iotBrainStorm/SOLAR_TRACKING_RS485/photos/Circuit_Diagram.pdf

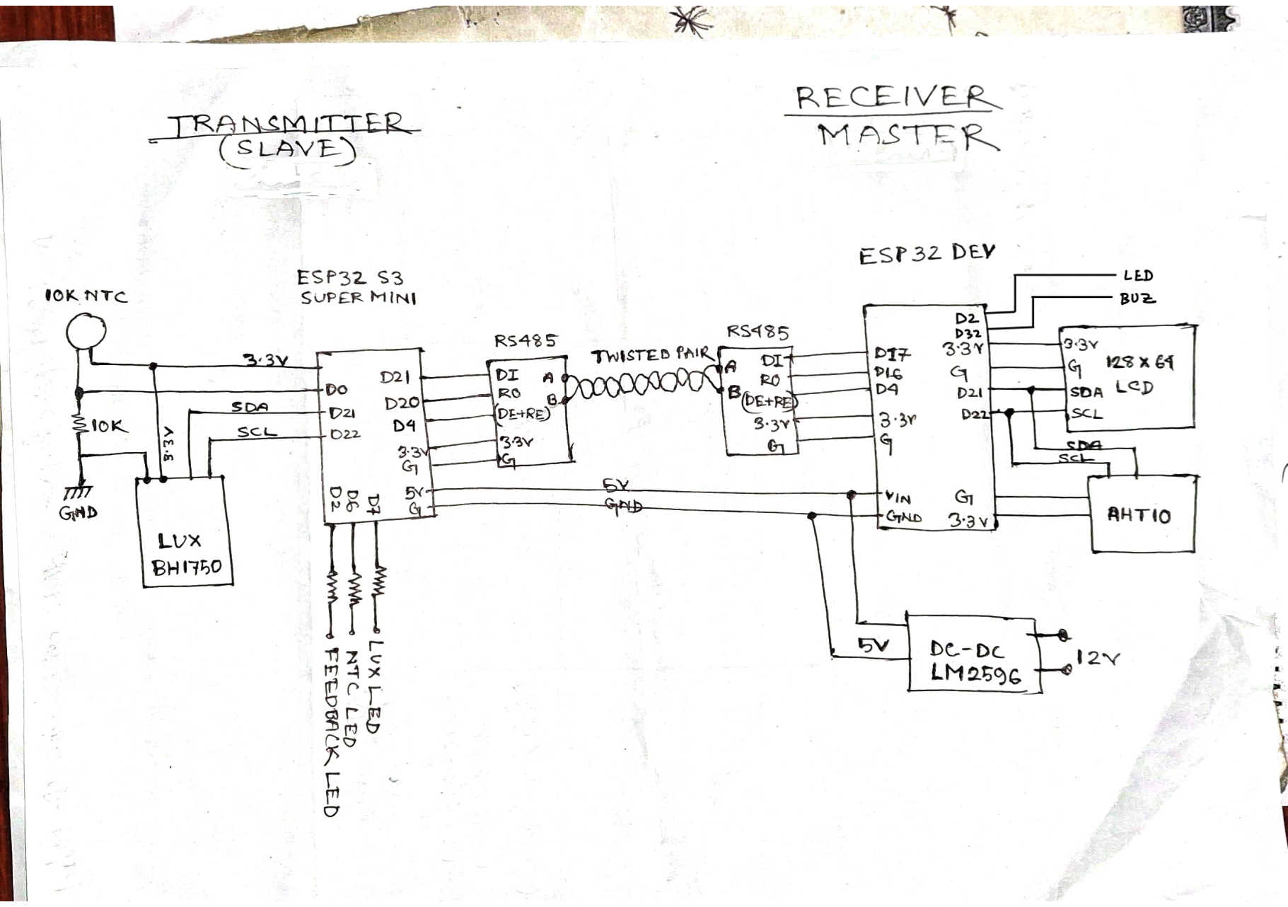
[picture p5: page 1]
