iotBrainStorm/SOLAR_TRACKING_RS485/photos/Circuit.pdf

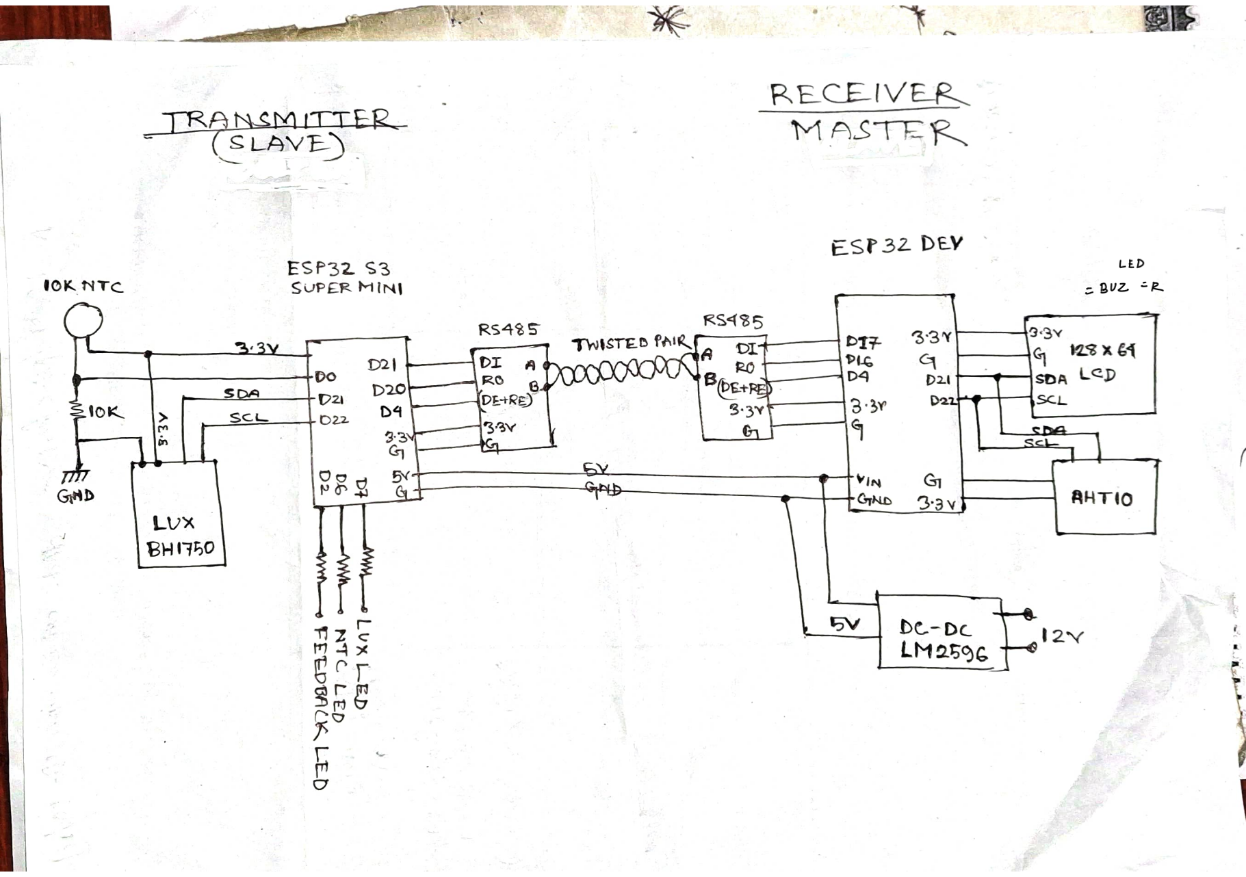
[picture p6: page 1]
