iotBrainStorm/SOLAR_TRACKING_RS485/mainLCD.jpg

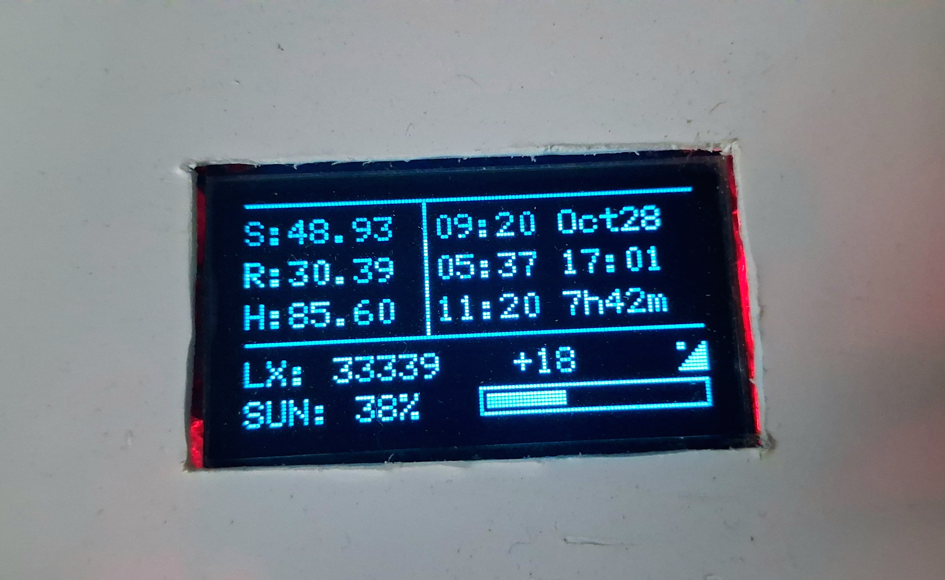
mainLCD.jpg
