iotBrainStorm/SOLAR_TRACKING_RS485/photos/config.png

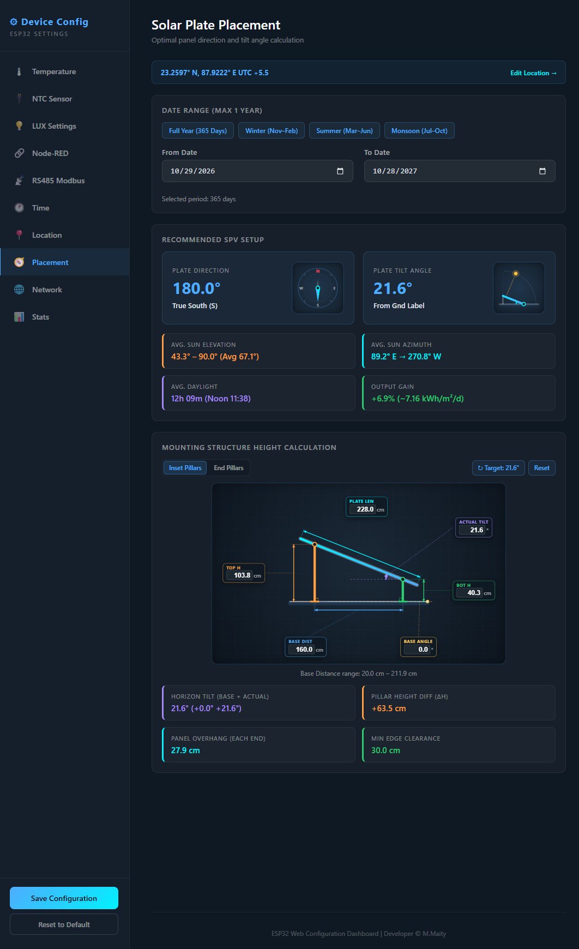
photos/config.png
