iotBrainStorm/SOLAR_TRACKING_RS485/photos/dashboard.png

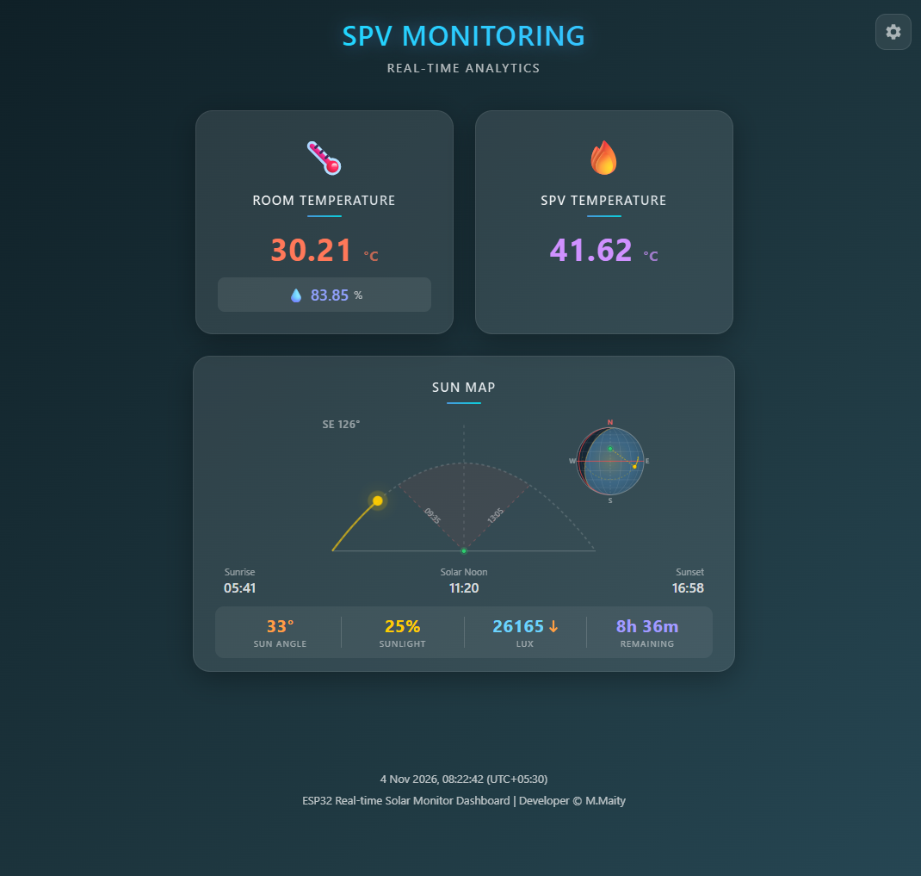
photos/dashboard.png
