iotBrainStorm/SOLAR_TRACKING_RS485/photos/LCD_view.jpg

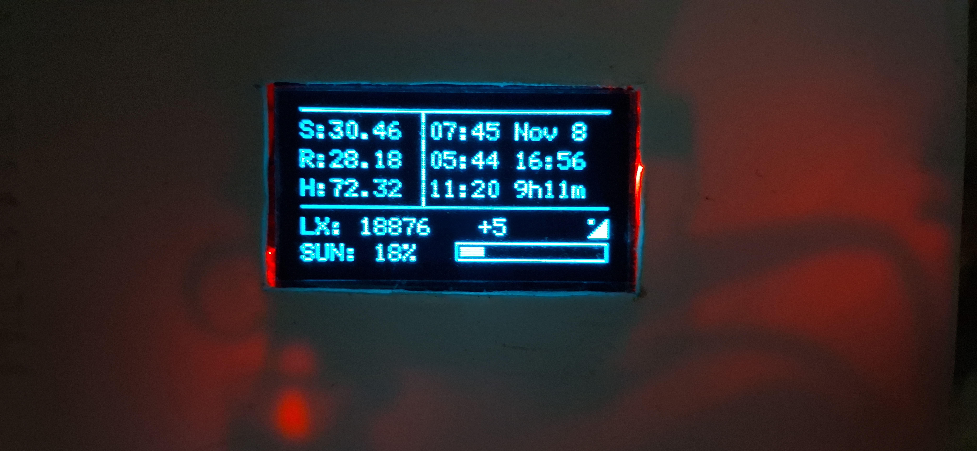
photos/LCD_view.jpg
