iotBrainStorm/SOLAR_TRACKING_RS485/photos/LUX_tilt.jpg

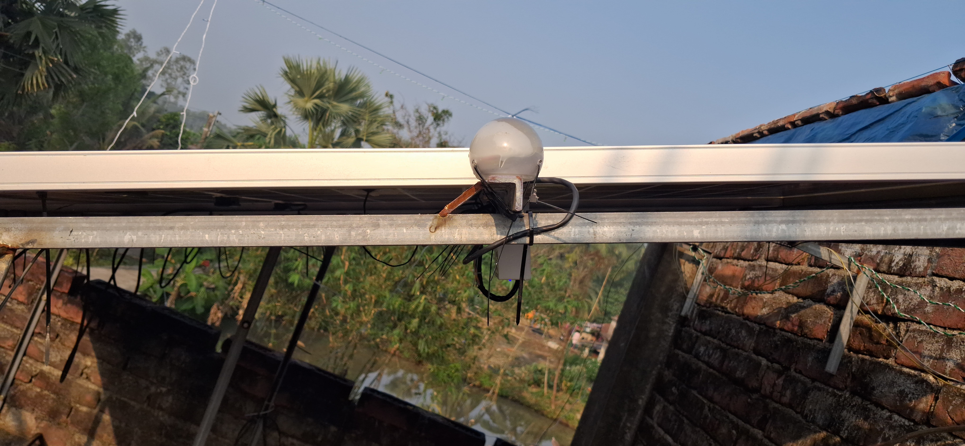
photos/LUX_tilt.jpg
