iotBrainStorm/SOLAR_TRACKING_RS485/photos/MOBILE view.jpg

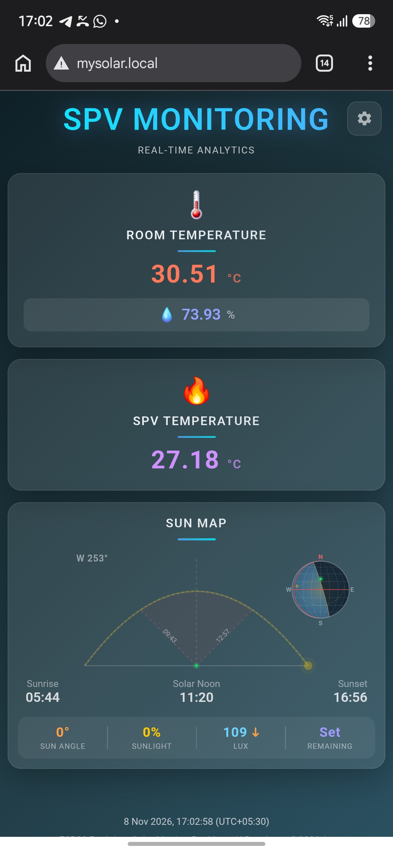
photos/MOBILE view.jpg
