iotBrainStorm/SOLAR_TRACKING_RS485/photos/NTC attachment.jpg

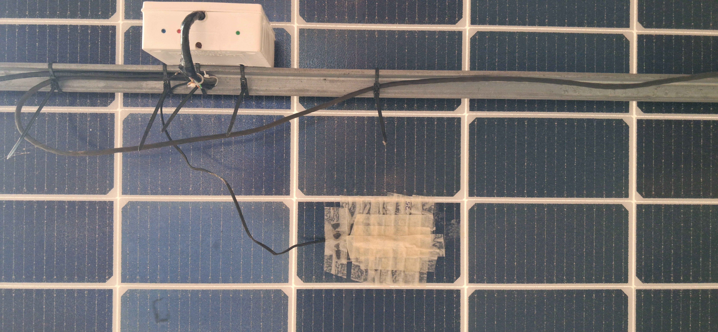
photos/NTC attachment.jpg
