iotBrainStorm/SOLAR_TRACKING_RS485/photos/TRANSMITTER_box.jpg

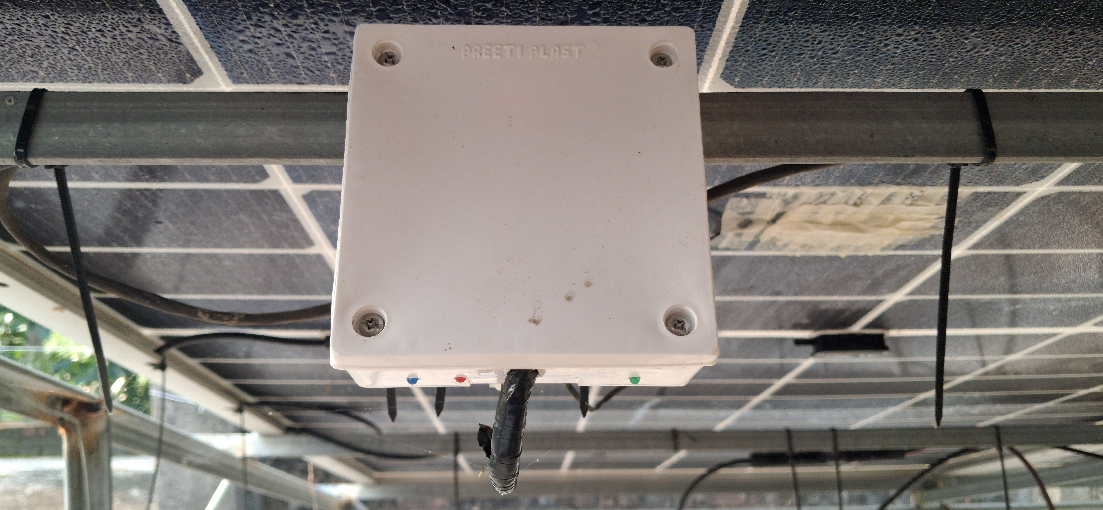
photos/TRANSMITTER_box.jpg
