iotBrainStorm/SOLAR_TRACKING_RS485/photos/WEB view 1.jpg

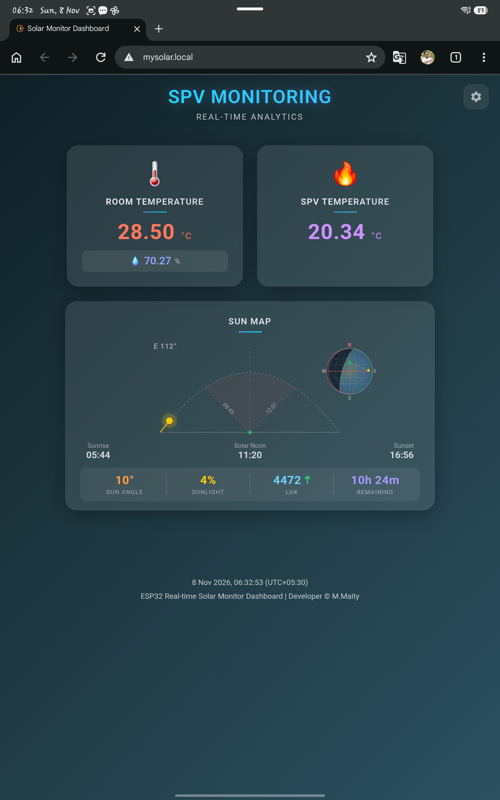
photos/WEB view 1.jpg
