iotBrainStorm/SOLAR_TRACKING_RS485/(commit log)

2026-03-06 lux sensor added
2026-03-12 Fix RS485 Modbus bugs: updateLED, luxConnected parsing, double-offset, spurious RX blink
    [RECEIVER.ino, SENDER.ino]
2026-03-14 temperature precision update at web dashboard, node status update, buzzer added for saving
    [RECEIVER.ino]
2026-04-13 over heating solved
2026-10-19 sender module sensor reading led status added
2026-10-29 plate placement recommendation features added
2026-11-08 circuit diagram updated
