iotBrainStorm/SOLAR_TRACKING_RS485/(notices)

Notices in the files:
README.md:
License: MIT
