iotBrainStorm/SOLAR_TRACKING_RS485/photos/LUX_front.jpg

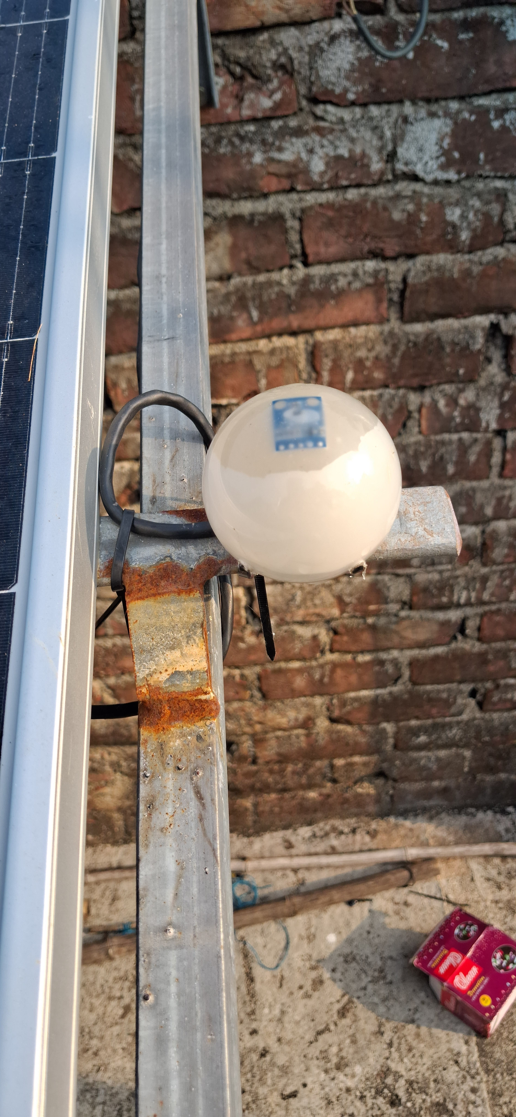
photos/LUX_front.jpg
